devjamescollier/STM32-Based_Programmable_Waveform_Generator/Hardware/KiCad_Files/3D_Models/USB-B-Micro.stp

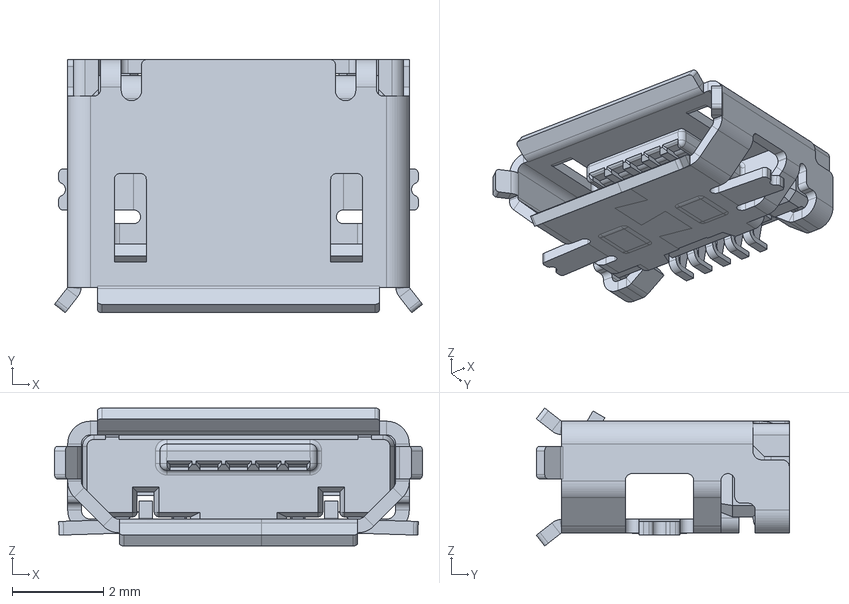
[picture p4: CAD file, 2026-05-27]
Hardware/KiCad_Files/3D_Models/USB-B-Micro.stp
8.08 x 5.56 x 3.03 mm
