devjamescollier/STM32-Based_Programmable_Waveform_Generator/Hardware/KiCad_Files/3D_Models/LM1117IMP-3-3-NOPB.stp

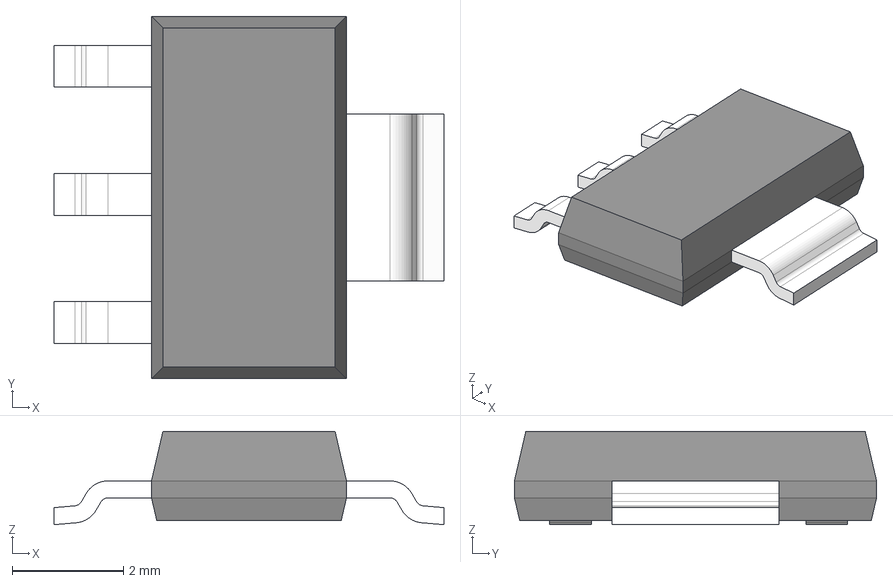
[picture p5: CAD file, 2026-05-27]
Hardware/KiCad_Files/3D_Models/LM1117IMP-3-3-NOPB.stp
7.00 x 6.50 x 1.68 mm
BODY-SOT
LEAD-SOT x 3
LEAD-SOT-WIDE
PIN1-ID
