devjamescollier/STM32-Based_Programmable_Waveform_Generator/Hardware/KiCad_Files/3D_Models/TC33X-2-XXX.stp

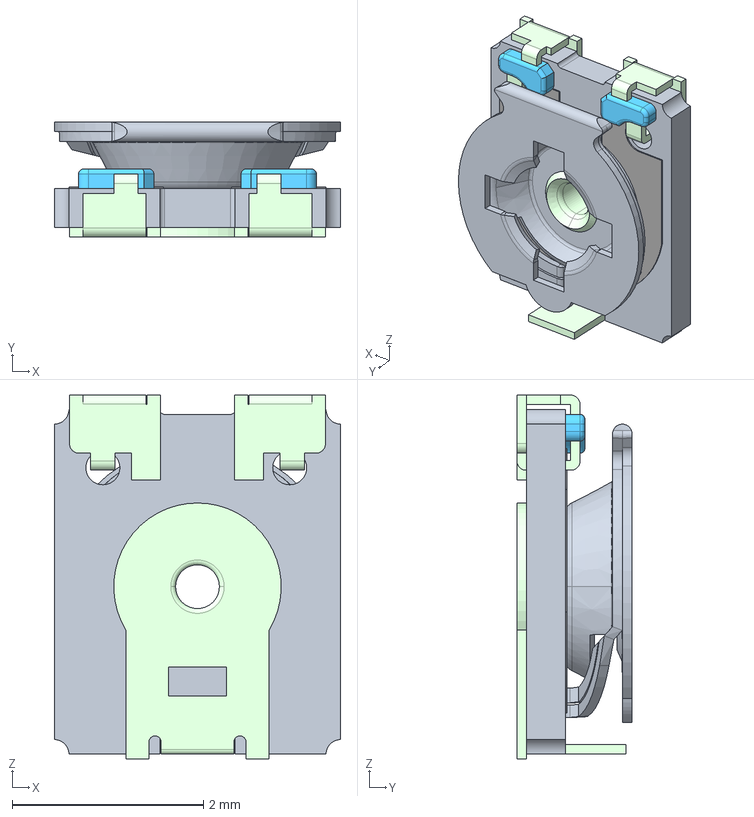
[picture p6: CAD file, 2026-05-27]
Hardware/KiCad_Files/3D_Models/TC33X-2-XXX.stp
3.00 x 1.20 x 3.81 mm
TC33X_SUBSTRATE
TC33X_ELEMENT
TC33X-2_COLLECTOR
TC33X_CONTACT
TC33X_TERMINALS
TC33X_SOLDER
