devjamescollier/STM32-Based_Programmable_Waveform_Generator/Docs/Images/STM32-Based_Programmable_Waveform_Generator_Schematic.pdf

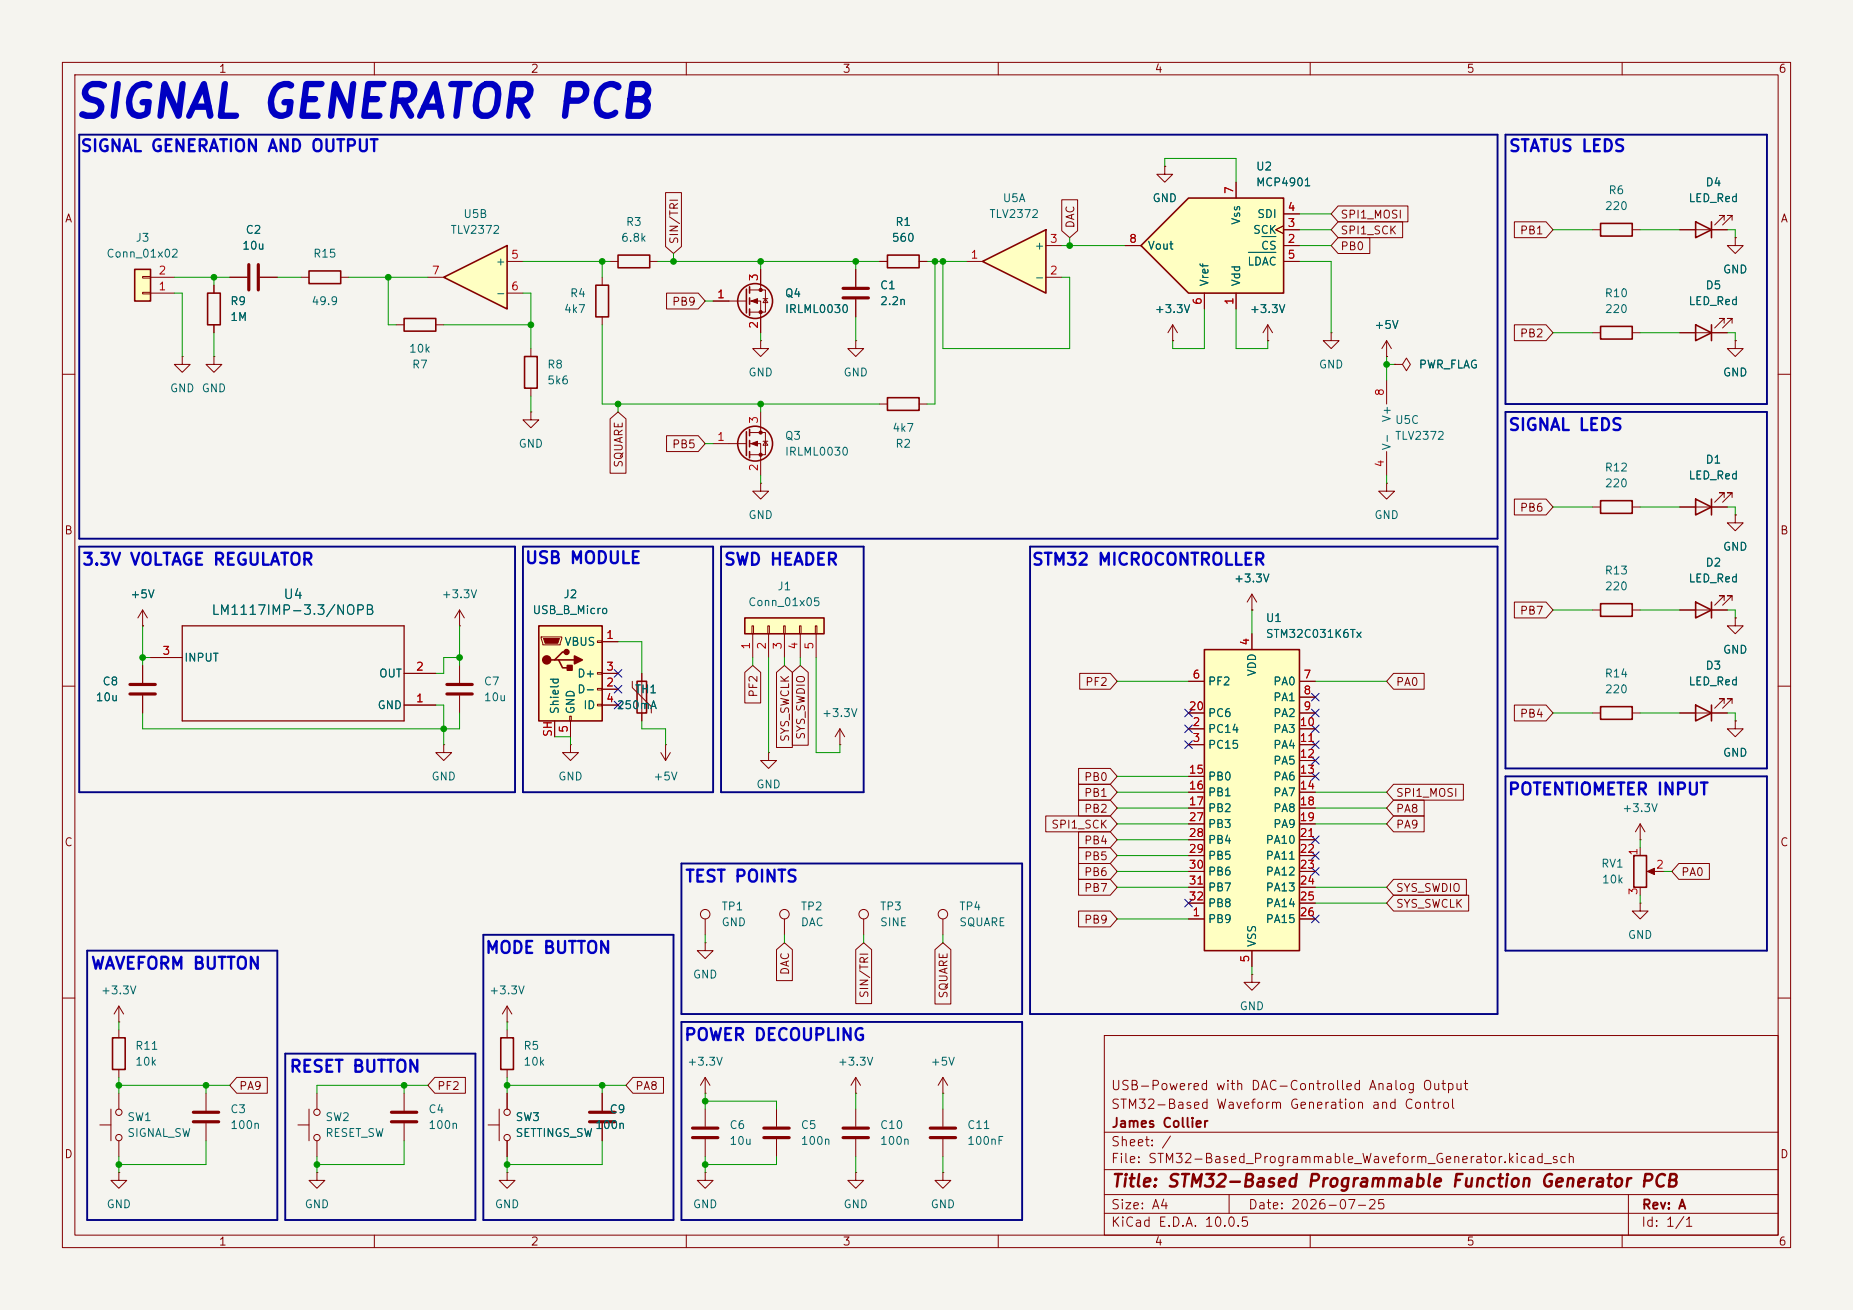
[picture p7: page 1]

SIGNAL GENERATION AND OUTPUT

USB-Powered with DAC-Controlled Analog Output C7

POTENTIOMETER INPUT 10k GND

MODE BUTTON | PA8

WAVEFORM BUTTON

RESET BUTTON

STM32-Based Waveform Generation and Control
James Collier
Sheet: /
File: STM32-Based_Programmable_Waveform_Generator.kicad_sch
Title: STM32-Based Programmable Function Generator PCB

Size: A4 | Rev: A
KiCad E.D.A. 10.0.5 | Id: 1/1
