devjamescollier/STM32-Based_Programmable_Waveform_Generator/Hardware/KiCad_Files/STM32-Based_Programmable_Waveform_Generator.kicad_pcb

## KiCad design Hardware/KiCad_Files/STM32-Based_Programmable_Waveform_Generator.kicad_pcb (2026-05-31)

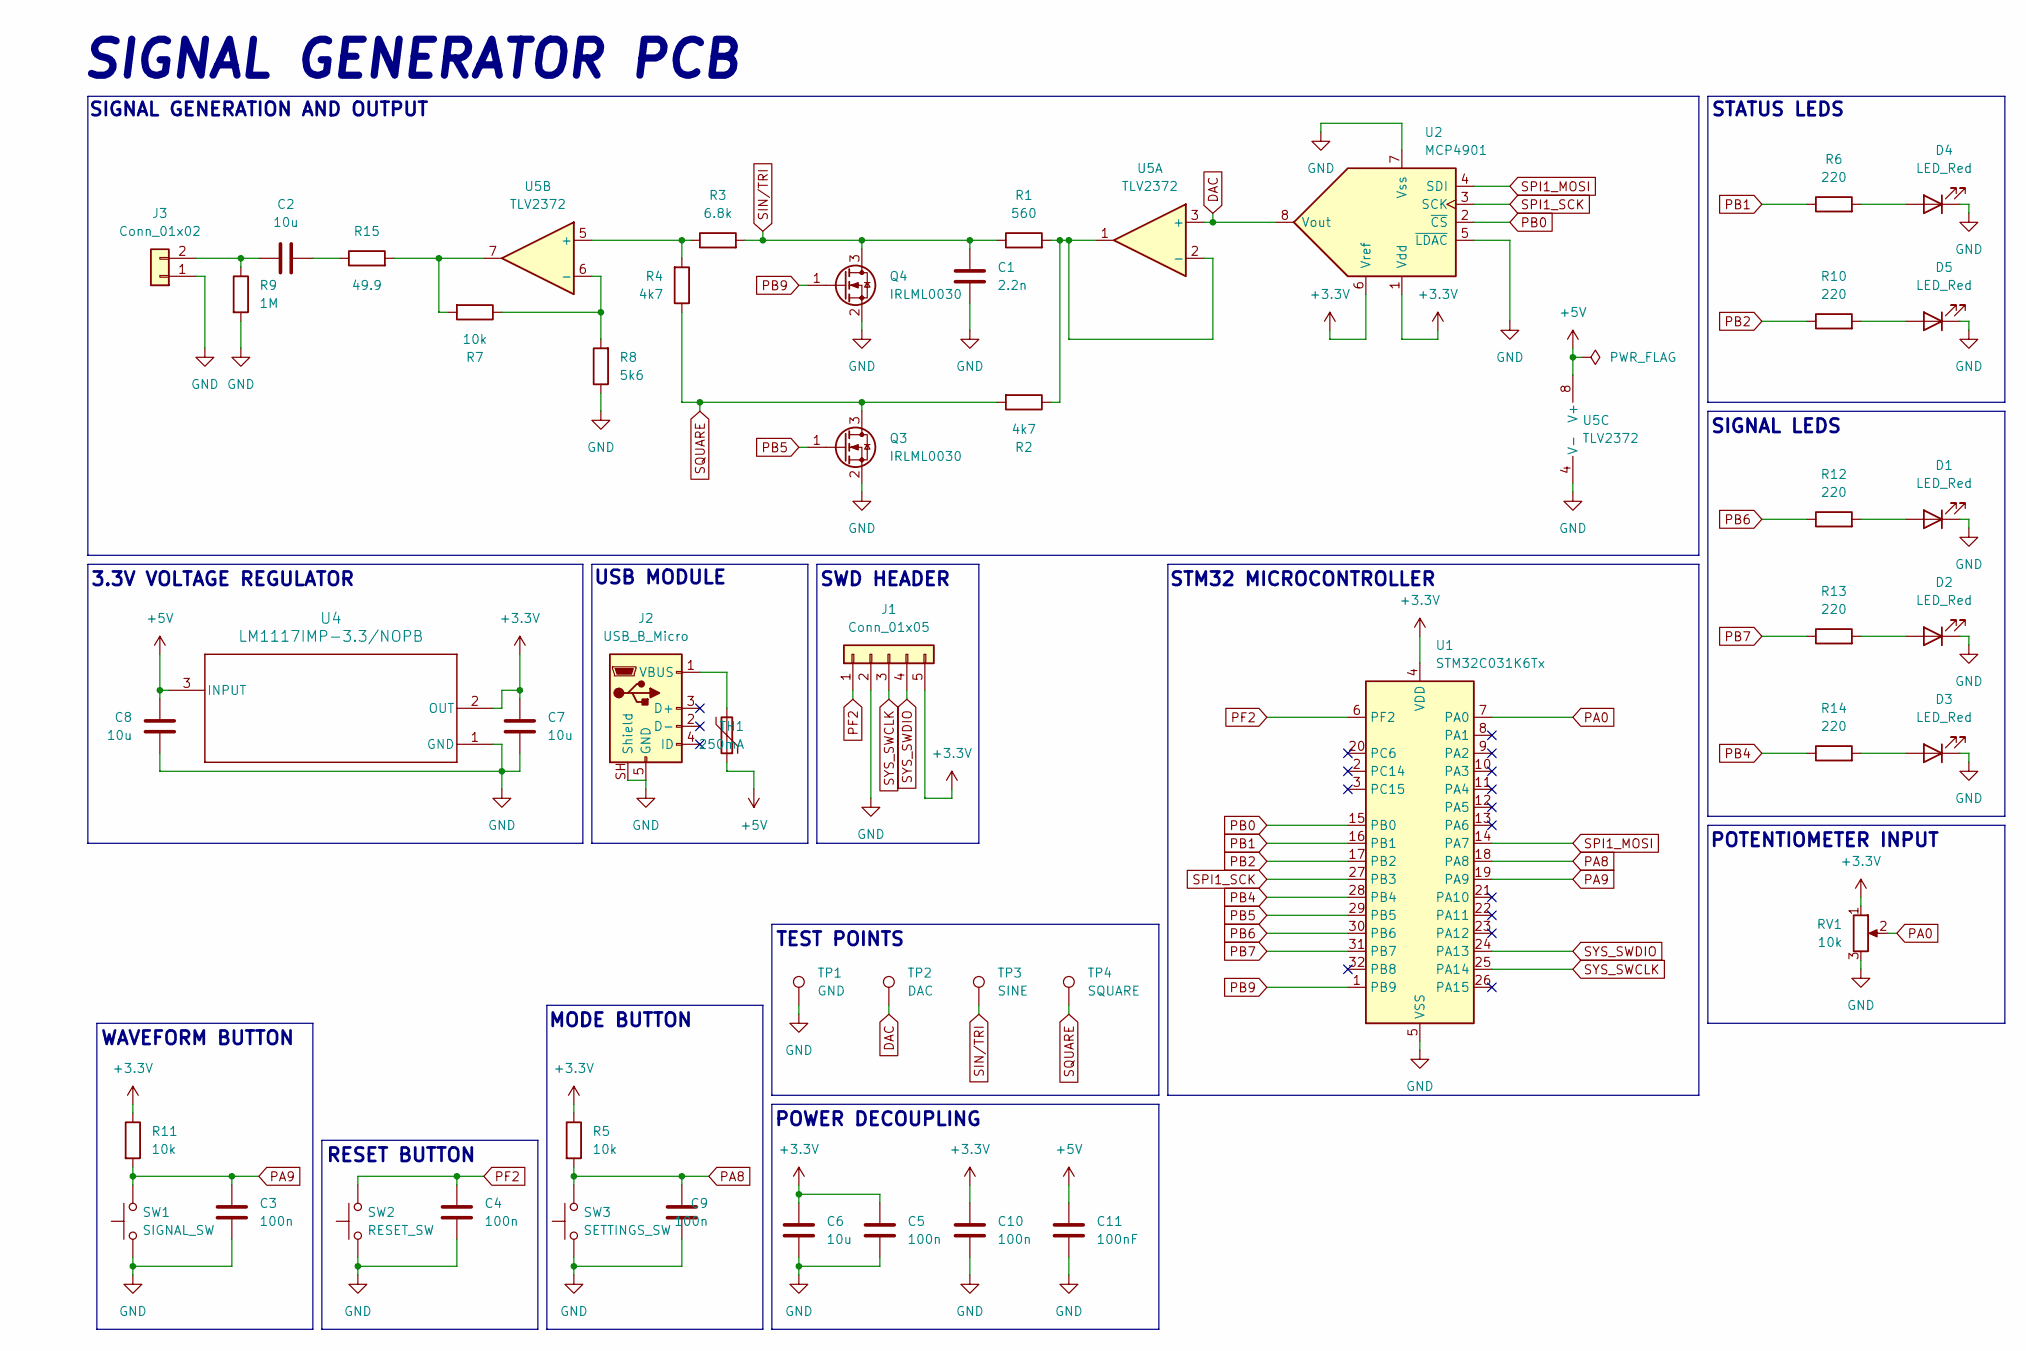
[picture p8: schematic STM32-Based_Programmable_Waveform_Generator.kicad_sch, STM32-Based Programmable Function Generator PCB]

Parts:
C1: 2.2n; C_0805_2012Metric
C2: 10u; C_1206_3216Metric
C3, C4, C5, C9, C10: 100n; C_0805_2012Metric
C6: 10u; C_0805_2012Metric
C7, C8: 10u; CP_EIA-3216-18_Kemet-A
C11: 100nF; C_0805_2012Metric
D1, D2, D3, D4, D5: LED_Red; LED_0805_2012Metric
J1: Conn_01x05; PinHeader_1x05_P2.54mm_Horizontal
J2: USB_B_Micro; USB_Micro-B_Amphenol_10104110_Horizontal
J3: Conn_01x02; JST_XH_B2B-XH-A_1x02_P2.50mm_Vertical
Q3, Q4: IRLML0030; SOT-23
R1: 560; R_0805_2012Metric
R2, R4: 4k7; R_0805_2012Metric
R3: 6.8k; R_0805_2012Metric
R5, R7, R11: 10k; R_0805_2012Metric
R6, R10, R12, R13, R14: 220; R_0805_2012Metric
R8: 5k6; R_0805_2012Metric
R9: 1M; R_0805_2012Metric
R15: 49.9; R_0805_2012Metric
RV1: 10k; Potentiometer_Bourns_TC33X_Vertical
SW1: SIGNAL_SW; SW_PUSH_6mm
SW2: RESET_SW; SW_PUSH_6mm
SW3: SETTINGS_SW; SW_PUSH_6mm
TH1: 250mA; Fuse_1206_3216Metric
TP1: GND; TestPoint_THTPad_D2.5mm_Drill1.2mm
TP2: DAC; TestPoint_THTPad_D2.5mm_Drill1.2mm
TP3: SINE; TestPoint_THTPad_D2.5mm_Drill1.2mm
TP4: SQUARE; TestPoint_THTPad_D2.5mm_Drill1.2mm
U1: STM32C031K6Tx; LQFP-32_7x7mm_P0.8mm
U2: MCP4901; SOIC-8_3.9x4.9mm_P1.27mm
U4: LM1117IMP-3.3/NOPB; SOT-223-3_TabPin2
U5: TLV2372; SOIC-8_3.9x4.9mm_P1.27mm

Connections:
+3.3V: C5.1, C6.1, C7.1, C10.1, J1.5, R5.1, R11.1, RV1.1, U1.4 (VDD), U2.1 (Vdd), U2.6 (Vref), U4.2 (OUT)
+5V: C8.1, C11.1, TH1.1, U4.3 (INPUT), U5.8 (V+)
DAC: TP2.1 (1_1), U2.8 (Vout), U5.3 (+)
GND: C1.2, C3.2, C4.2, C5.2, C6.2, C7.2, C8.2, C9.1, C10.2, C11.2, D1.1 (K), D2.1 (K), D3.1 (K), D4.1 (K), D5.1 (K), J1.2, J2.5 (GND), J2.SH (Shield), J3.1, Q3.2 (S), Q4.2 (S), R8.1, R9.2, RV1.3, SW1.1, SW2.1, SW3.1, TP1.1 (1_1), U1.5 (VSS), U2.5 (~LDAC), U2.7 (Vss), U4.1 (GND), U5.4 (V-)
unnamed: C2.2, R15.1
unnamed: D1.2 (A), R12.2
unnamed: D2.2 (A), R13.2
unnamed: D3.2 (A), R14.2
unnamed: D4.2 (A), R6.2
unnamed: D5.2 (A), R10.2
unnamed: J2.1 (VBUS), TH1.2
unnamed: C2.1, J3.2, R9.1
unnamed: R7.2, R15.2, U5.7
unnamed: R1.2, R2.1, U5.1, U5.2 (-)
unnamed: R3.1, R4.2, U5.5 (+)
unnamed: R7.1, R8.2, U5.6 (-)
PA0: RV1.2, U1.7 (PA0)
PA8: C9.2, R5.2, SW3.2, U1.18 (PA8)
PA9: C3.1, R11.2, SW1.2, U1.19 (PA9)
PB0: U1.15 (PB0), U2.2 (~CS)
PB1: R6.1, U1.16 (PB1)
PB2: R10.1, U1.17 (PB2)
PB4: R14.1, U1.28 (PB4)
PB5: Q3.1 (G), U1.29 (PB5)
PB6: R12.1, U1.30 (PB6)
PB7: R13.1, U1.31 (PB7)
PB9: Q4.1 (G), U1.1 (PB9)
PF2: C4.1, J1.1, SW2.2, U1.6 (PF2)
SIN/TRI: C1.1, Q4.3 (D), R1.1, R3.2, TP3.1 (1_1)
SPI1_MOSI: U1.14 (PA7), U2.4 (SDI)
SPI1_SCK: U1.27 (PB3), U2.3 (SCK)
SQUARE: Q3.3 (D), R2.2, R4.1, TP4.1 (1_1)
SYS_SWCLK: J1.3, U1.25 (PA14)
SYS_SWDIO: J1.4, U1.24 (PA13)

Notes on the sheet:
WAVEFORM BUTTON
POWER DECOUPLING
SIGNAL GENERATOR PCB
SWD HEADER
STATUS LEDS
SIGNAL LEDS
MODE BUTTON
RESET BUTTON
TEST POINTS
POTENTIOMETER INPUT
SIGNAL GENERATION AND OUTPUT
USB MODULE
STM32 MICROCONTROLLER
3.3V VOLTAGE REGULATOR

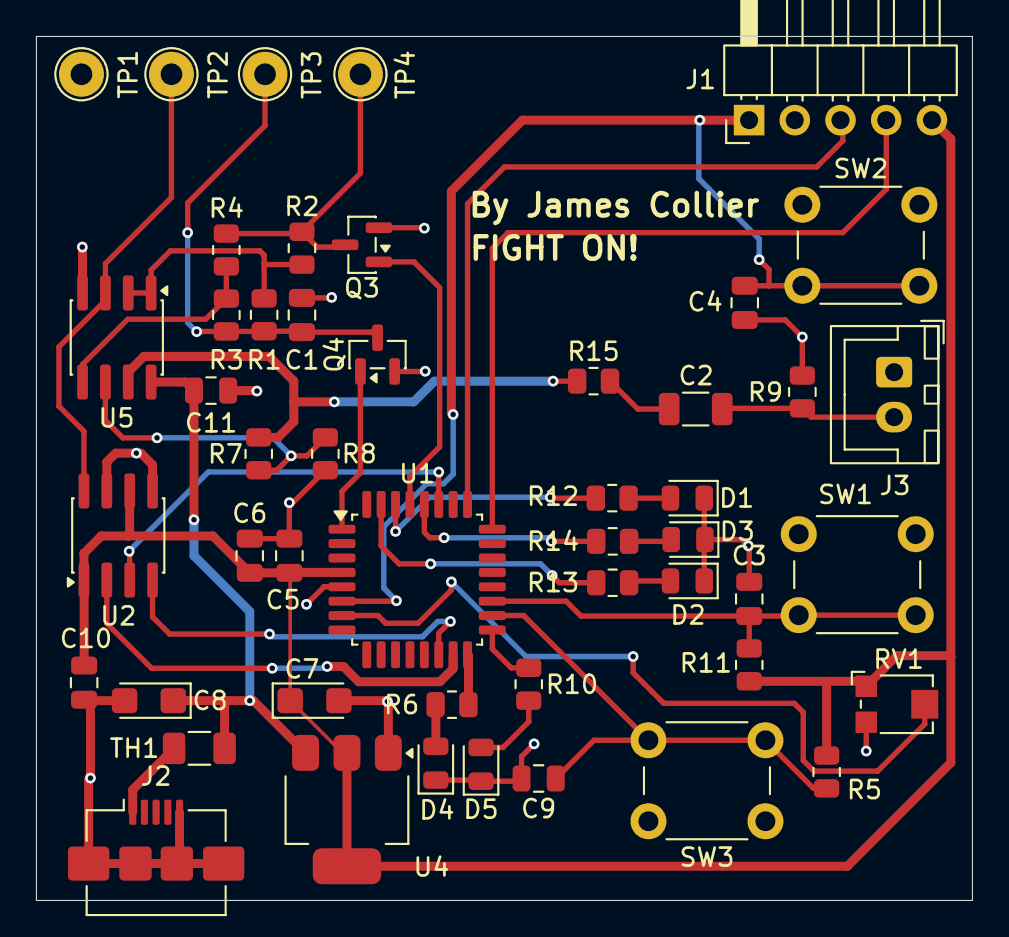
[picture p9: board STM32-Based_Programmable_Waveform_Generator.kicad_pcb from above]

Board: 2 copper layers, 52.0 x 48.0 mm, 49 parts (0 on the bottom side), 34 nets.
