devjamescollier/STM32-Based_Programmable_Waveform_Generator/Software/main.c

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
/* Includes ------------------------------------------------------------------*/
#include "main.h"

/* USER CODE BEGIN Includes */
#include <stdbool.h>
#include <math.h>
#include <stdint.h>

/* USER CODE END Includes */

ADC_HandleTypeDef hadc1;

SPI_HandleTypeDef hspi1;

TIM_HandleTypeDef htim14;
TIM_HandleTypeDef htim16;

UART_HandleTypeDef huart2;

/* USER CODE BEGIN PV */

#define WAVE_TABLE_SIZE          256U
#define ADC_FULL_SCALE           4095U
#define DAC_MID_SCALE            128U
#define DAC_MAX_AMPLITUDE        127U
#define MAX_ANALOG_FREQUENCY_HZ  50000UL
#define MAX_SQUARE_FREQUENCY_HZ  100000UL
#define MAX_SAMPLE_RATE_HZ       200000UL
#define TIM16_INPUT_CLOCK_HZ     64000000UL
#define BUTTON_DEBOUNCE_MS       50UL
#define ADC_UPDATE_PERIOD_MS     10UL

typedef enum
{
  WAVE_SINE = 0,
  WAVE_TRIANGLE,
  WAVE_SQUARE,
  WAVE_COUNT
} Waveform_t;

typedef enum
{
  CONTROL_FREQUENCY = 0,
  CONTROL_AMPLITUDE
} ControlMode_t;

static uint8_t wave_tables[2][WAVE_TABLE_SIZE];
static uint8_t * volatile active_wave_table = wave_tables[0];
static volatile uint32_t phase_accumulator = 0U;
static volatile uint32_t phase_increment = 0U;
static volatile Waveform_t waveform = WAVE_SQUARE;
static volatile ControlMode_t control_mode = CONTROL_FREQUENCY;
static volatile bool waveform_button_event = false;
static volatile bool control_button_event = false;

static uint8_t amplitude_code = DAC_MAX_AMPLITUDE;
static uint32_t frequency_hz = 1000U;
/* USER CODE END PV */

void SystemClock_Config(void);
static void MX_GPIO_Init(void);
static void MX_USART2_UART_Init(void);
static void MX_SPI1_Init(void);
static void MX_TIM16_Init(void);
static void MX_ADC1_Init(void);
static void MX_TIM14_Init(void);
/* USER CODE BEGIN PFP */
static uint16_t MCP4901_Frame(uint8_t sample);
static void DAC_Write(uint8_t sample);
static void WaveTable_Rebuild(void);
static void OutputRouting_Update(void);
static void ControlLeds_Update(void);
static uint16_t ADC_ReadFiltered(void);
static uint32_t FrequencyFromAdc(uint16_t adc_value, uint32_t maximum_hz);
static void GeneratorFrequency_Update(void);
static void UserInterface_Process(void);
/* USER CODE END PFP */

/* USER CODE BEGIN 0 */
/* MCP4901 frame: channel A, unbuffered Vref, 1x gain, active output. */
static uint16_t MCP4901_Frame(uint8_t sample)
{
  return (uint16_t)(0x3000U | ((uint16_t)sample << 4));
}

static void DAC_Write(uint8_t sample)
{
  const uint16_t frame = MCP4901_Frame(sample);
  uint8_t tx[2] = {(uint8_t)(frame >> 8), (uint8_t)frame};

  HAL_GPIO_WritePin(GPIOB, GPIO_PIN_0, GPIO_PIN_RESET);
  (void)HAL_SPI_Transmit(&hspi1, tx, sizeof(tx), 1U);
  HAL_GPIO_WritePin(GPIOB, GPIO_PIN_0, GPIO_PIN_SET);
}

static void WaveTable_Rebuild(void)
{
  uint32_t i;
  uint8_t * const build_table =
      (active_wave_table == wave_tables[0]) ? wave_tables[1] : wave_tables[0];

  for (i = 0U; i < WAVE_TABLE_SIZE; ++i)
  {
    int32_t signed_sample;

    switch (waveform)
    {
      case WAVE_SINE:
        signed_sample = (int32_t)lroundf(
            sinf((2.0f * 3.14159265358979323846f * (float)i) /
                 (float)WAVE_TABLE_SIZE) * (float)amplitude_code);
        break;

      case WAVE_TRIANGLE:
        if (i < 64U)
        {
          signed_sample = (int32_t)((i * (uint32_t)amplitude_code) / 64U);
        }
        else if (i < 192U)
        {
          signed_sample = (int32_t)amplitude_code -
              (int32_t)(((i - 64U) * 2U * (uint32_t)amplitude_code) / 128U);
        }
        else
        {
          signed_sample = -(int32_t)amplitude_code +
              (int32_t)(((i - 192U) * (uint32_t)amplitude_code) / 64U);
        }
        break;

      case WAVE_SQUARE:
      default:
        signed_sample = (i < (WAVE_TABLE_SIZE / 2U)) ?
            (int32_t)amplitude_code : -(int32_t)amplitude_code;
        break;
    }

    build_table[i] = (uint8_t)((int32_t)DAC_MID_SCALE + signed_sample);
  }

  /* Swap complete tables atomically so amplitude changes do not tear a cycle. */
  __disable_irq();
  active_wave_table = build_table;
  __enable_irq();
}

static void OutputRouting_Update(void)
{
  const bool square = (waveform == WAVE_SQUARE);

  /* Q3/PB5 mutes the square path; Q4/PB9 mutes the sine/triangle path. */
  HAL_GPIO_WritePin(GPIOB, GPIO_PIN_5, square ? GPIO_PIN_RESET : GPIO_PIN_SET);
  HAL_GPIO_WritePin(GPIOB, GPIO_PIN_9, square ? GPIO_PIN_SET : GPIO_PIN_RESET);

  HAL_GPIO_WritePin(GPIOB, GPIO_PIN_6,
                    (waveform == WAVE_SINE) ? GPIO_PIN_SET : GPIO_PIN_RESET);
  HAL_GPIO_WritePin(GPIOB, GPIO_PIN_4,
                    (waveform == WAVE_TRIANGLE) ? GPIO_PIN_SET : GPIO_PIN_RESET);
  HAL_GPIO_WritePin(GPIOB, GPIO_PIN_7,
                    square ? GPIO_PIN_SET : GPIO_PIN_RESET);
}

static void ControlLeds_Update(void)
{
  HAL_GPIO_WritePin(GPIOB, GPIO_PIN_1,
                    (control_mode == CONTROL_AMPLITUDE) ? GPIO_PIN_SET : GPIO_PIN_RESET);
  HAL_GPIO_WritePin(GPIOB, GPIO_PIN_2,
                    (control_mode == CONTROL_FREQUENCY) ? GPIO_PIN_SET : GPIO_PIN_RESET);
}

static uint16_t ADC_ReadFiltered(void)
{
  uint32_t sum = 0U;

  for (uint32_t i = 0U; i < 8U; ++i)
  {
    if (HAL_ADC_Start(&hadc1) != HAL_OK)
    {
      Error_Handler();
    }
    if (HAL_ADC_PollForConversion(&hadc1, 2U) != HAL_OK)
    {
      Error_Handler();
    }
    sum += HAL_ADC_GetValue(&hadc1);
  }

  return (uint16_t)((sum + 4U) / 8U);
}

/* Logarithmic control makes the 1 Hz end usable while still reaching 100 kHz. */
static uint32_t FrequencyFromAdc(uint16_t adc_value, uint32_t maximum_hz)
{
  const float position = (float)adc_value / (float)ADC_FULL_SCALE;
  uint32_t result = (uint32_t)lroundf(powf((float)maximum_hz, position));

  if (result < 1U)
  {
    result = 1U;
  }
  if (result > maximum_hz)
  {
    result = maximum_hz;
  }
  return result;
}

static void GeneratorFrequency_Update(void)
{
  uint32_t desired_samples_per_cycle;
  uint32_t sample_rate;
  uint32_t timer_ticks;

  desired_samples_per_cycle = (waveform == WAVE_SQUARE) ? 2U : WAVE_TABLE_SIZE;
  sample_rate = frequency_hz * desired_samples_per_cycle;
  if (sample_rate > MAX_SAMPLE_RATE_HZ)
  {
    sample_rate = MAX_SAMPLE_RATE_HZ;
  }
  if (sample_rate < (frequency_hz * 2U))
  {
    sample_rate = frequency_hz * 2U;
  }

  timer_ticks = (TIM16_INPUT_CLOCK_HZ + (sample_rate / 2U)) / sample_rate;
  if (timer_ticks < 1U)
  {
    timer_ticks = 1U;
  }
  if (timer_ticks > 65536U)
  {
    timer_ticks = 65536U;
  }
  sample_rate = TIM16_INPUT_CLOCK_HZ / timer_ticks;

  __disable_irq();
  __HAL_TIM_SET_AUTORELOAD(&htim16, timer_ticks - 1U);
  __HAL_TIM_SET_COUNTER(&htim16, 0U);
  phase_increment = (uint32_t)((((uint64_t)frequency_hz << 32) +
                               (sample_rate / 2U)) / sample_rate);
  phase_accumulator = 0U;
  __enable_irq();
}

static void UserInterface_Process(void)
{
  static uint32_t last_waveform_event_ms = 0U;
  static uint32_t last_control_event_ms = 0U;
  static uint32_t last_adc_ms = 0U;
  static uint16_t previous_adc = 0xFFFFU;
  const uint32_t now = HAL_GetTick();

  if (waveform_button_event)
  {
    waveform_button_event = false;
    if ((now - last_waveform_event_ms) >= BUTTON_DEBOUNCE_MS)
    {
      last_waveform_event_ms = now;
      waveform = (Waveform_t)(((uint32_t)waveform + 1U) % (uint32_t)WAVE_COUNT);
      if ((waveform != WAVE_SQUARE) && (frequency_hz > MAX_ANALOG_FREQUENCY_HZ))
      {
        frequency_hz = MAX_ANALOG_FREQUENCY_HZ;
      }
      WaveTable_Rebuild();
      OutputRouting_Update();
      GeneratorFrequency_Update();
    }
  }

  if (control_button_event)
  {
    control_button_event = false;
    if ((now - last_control_event_ms) >= BUTTON_DEBOUNCE_MS)
    {
      last_control_event_ms = now;
      control_mode = (control_mode == CONTROL_FREQUENCY) ?
          CONTROL_AMPLITUDE : CONTROL_FREQUENCY;
      previous_adc = 0xFFFFU; /* Apply the pot immediately in the new mode. */
      ControlLeds_Update();
    }
  }

  if ((now - last_adc_ms) >= ADC_UPDATE_PERIOD_MS)
  {
    const uint16_t adc = ADC_ReadFiltered();
    last_adc_ms = now;

    if ((previous_adc == 0xFFFFU) ||
        ((adc > previous_adc) ? (adc - previous_adc) : (previous_adc - adc)) >= 8U)
    {
      previous_adc = adc;
      if (control_mode == CONTROL_AMPLITUDE)
      {
        amplitude_code = (uint8_t)(((uint32_t)adc * DAC_MAX_AMPLITUDE +
                                    (ADC_FULL_SCALE / 2U)) / ADC_FULL_SCALE);
        WaveTable_Rebuild();
      }
      else
      {
        const uint32_t maximum_hz = (waveform == WAVE_SQUARE) ?
            MAX_SQUARE_FREQUENCY_HZ : MAX_ANALOG_FREQUENCY_HZ;
        frequency_hz = FrequencyFromAdc(adc, maximum_hz);
        GeneratorFrequency_Update();
      }
    }
  }
}

/* USER CODE END 0 */

/**
  * @brief  The application entry point.
  * @retval int
  */
int main(void)
{
  /* MCU Configuration--------------------------------------------------------*/

  /* Reset of all peripherals, Initializes the Flash interface and the Systick. */
  HAL_Init();

  /* Configure the system clock */
  SystemClock_Config();

  /* Initialize all configured peripherals */
  MX_GPIO_Init();
  MX_USART2_UART_Init();
  MX_SPI1_Init();
  MX_TIM16_Init();
  MX_ADC1_Init();
  MX_TIM14_Init();
  /* USER CODE BEGIN 2 */
  HAL_GPIO_WritePin(GPIOB, GPIO_PIN_0, GPIO_PIN_SET);
  WaveTable_Rebuild();
  OutputRouting_Update();
  ControlLeds_Update();
  GeneratorFrequency_Update();

  if (HAL_TIM_Base_Start_IT(&htim16) != HAL_OK)
  {
    Error_Handler();
  }
  /* USER CODE END 2 */

  /* Infinite loop */
  /* USER CODE BEGIN WHILE */
  while (1)
  {
    UserInterface_Process();
    /* USER CODE END WHILE */

    /* USER CODE BEGIN 3 */
  }
  /* USER CODE END 3 */
}

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
/* USER CODE BEGIN 4 */


/**
 * @brief Callback function triggered on falling edge interrupt for GPIO pins.
 *
 * This function is called when a falling edge interrupt is detected on the specified GPIO pin.
 * If the GPIO pin is GPIO_PIN_9, it increments the mode variable cyclically from 1 to 3
 * to choose what kind of signals display.
 * If the GPIO pin is GPIO_PIN_8, it toggles the change_amplitude
 * boolean variable and adjusts GPIO pins accordingly for visual feedback.
 *
 * @param GPIO_Pin The GPIO pin that triggered the falling edge interrupt.
 *
 * @return None.
 */
void HAL_GPIO_EXTI_Falling_Callback(uint16_t GPIO_Pin)
{
  if (GPIO_Pin == GPIO_PIN_9)
  {
    waveform_button_event = true;
  }
  else if (GPIO_Pin == GPIO_PIN_8)
  {
    control_button_event = true;
  }
}

void HAL_TIM_PeriodElapsedCallback(TIM_HandleTypeDef *htim)
{
  if (htim->Instance == TIM16)
  {
    const uint8_t table_index = (uint8_t)(phase_accumulator >> 24);
    phase_accumulator += phase_increment;
    DAC_Write(active_wave_table[table_index]);
  }
}
/* USER CODE END 4 */
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
