devjamescollier/STM32-Based_Programmable_Waveform_Generator/(commit log)

2026-05-27 Add KiCad symbols, footprints, and 3D models
    [LM1117IMP-3-3-NOPB.stp, TC33X-2-XXX.stp, USB-B-Micro.stp]
2026-05-29 Add schematic and KiCad project file
    [STM32-Based_Programmable_Waveform_Generator.kicad_sch]
2026-05-31 Add routed PCB layout
    [STM32-Based_Programmable_Waveform_Generator.kicad_pcb]
2026-06-03 Add Gerber and drill files
    [STM32-Based_Programmable_Waveform_Generator-B_Cu.gbl, STM32-Based_Programmable_Waveform_Generator-B_Mask.gbs, STM32-Based_Programmable_Waveform_Generator-B_Paste.gbp, STM32-Based_Programmable_Waveform_Generator-B_Silkscreen.gbo, STM32-Based_Programmable_Waveform_Generator-Edge_Cuts.gm1, STM32-Based_Programmable_Waveform_Generator-F_Cu.gtl, STM32-Based_Programmable_Waveform_Generator-F_Mask.gts, S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]
2026-06-04 Add pick-and-place file
    [STM32-Based_Programmable_Waveform_Generator-all-pos.csv]
2026-06-05 Add JLCPCB fabrication package
    [Waveform_Generator_JLCPCB_BOM.csv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]
2026-06-06 Add schematic exports and board renders
