devjamescollier/STM32-Based_Programmable_Waveform_Generator/(notices)

Notices in the files:
Software/main.c:
Copyright (c) 2023 STMicroelectronics.
All rights reserved.
This software is licensed under terms that can be found in the LICENSE file
README.md:
Hardware License: CERN-OHL-P-2.0
